yuitsu-leather/ULP_leather_keycap/img/IMG_7734.jpg

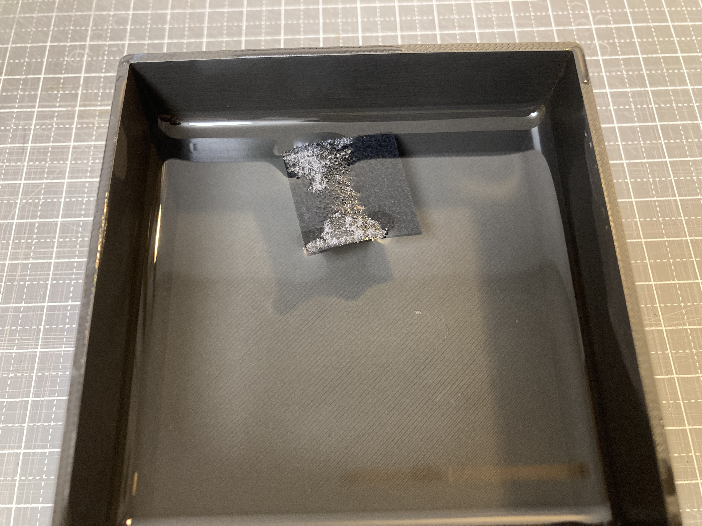
img/IMG_7734.jpg
