yuitsu-leather/ULP_leather_keycap/model/common/leather_ruler_guide_22mm.stl

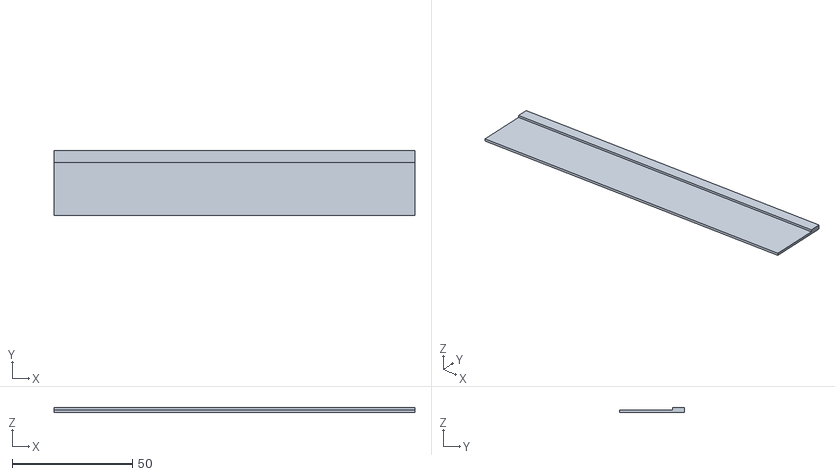
[picture p21: CAD file, 2026-11-08]
model/common/leather_ruler_guide_22mm.stl
150.0 x 27.0 x 1.90
