yuitsu-leather/ULP_leather_keycap/model/cylindrical/cylindrical_press.stl

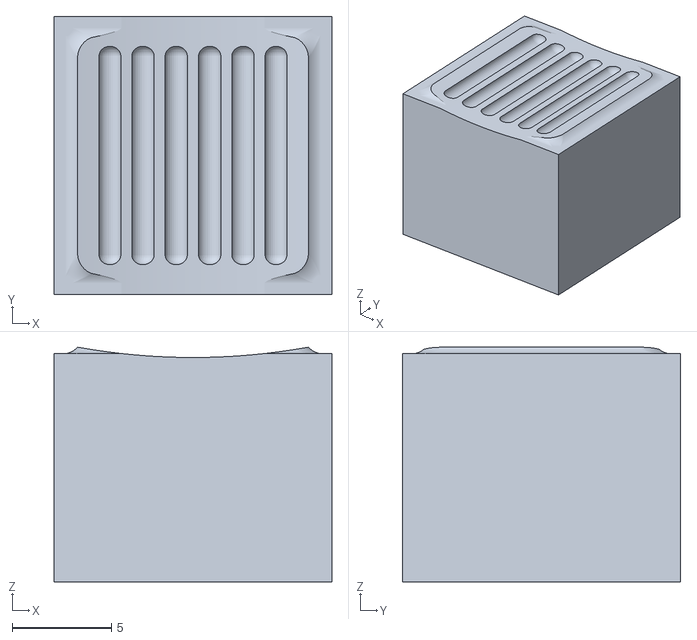
[picture p22: CAD file, 2026-11-06]
model/cylindrical/cylindrical_press.stl
14.0 x 14.0 x 11.8
