yuitsu-leather/ULP_leather_keycap/model/common/hook.stl

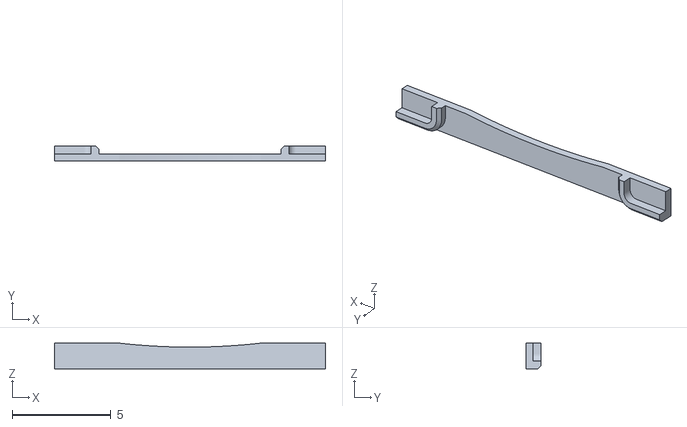
[picture p23: CAD file, 2026-11-06]
model/common/hook.stl
13.7 x 0.75 x 1.30
