yuitsu-leather/ULP_leather_keycap/model/cylindrical/cylindrical_cutting_guide.stl

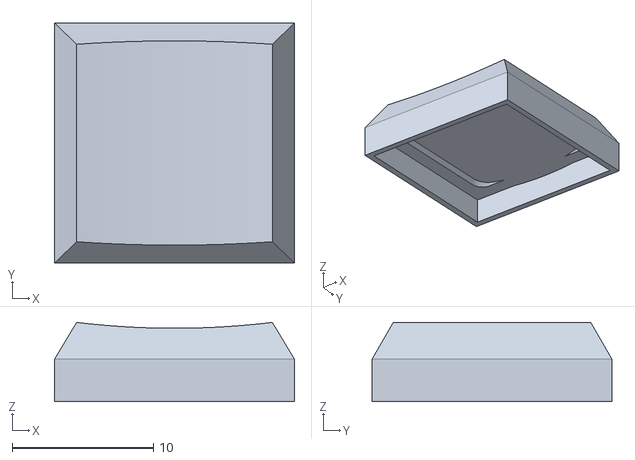
[picture p24: CAD file, 2026-11-06]
model/cylindrical/cylindrical_cutting_guide.stl
17.0 x 17.0 x 5.61
