yuitsu-leather/ULP_leather_keycap/model/common/spatula.stl

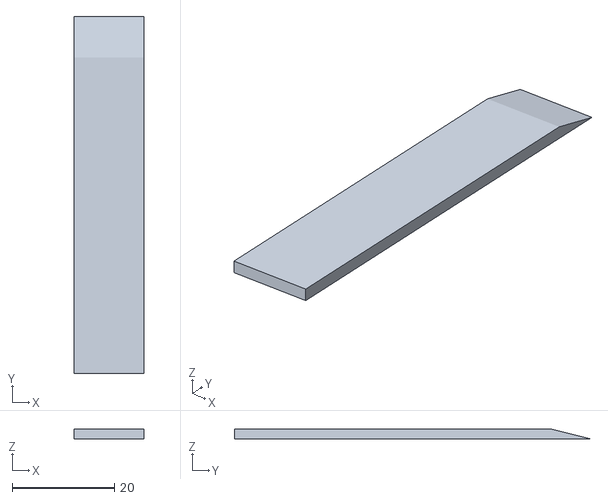
[picture p25: CAD file, 2026-11-06]
model/common/spatula.stl
13.7 x 70.0 x 2.00
