yuitsu-leather/ULP_leather_keycap/model/cylindrical/cylindrical_mold.stl

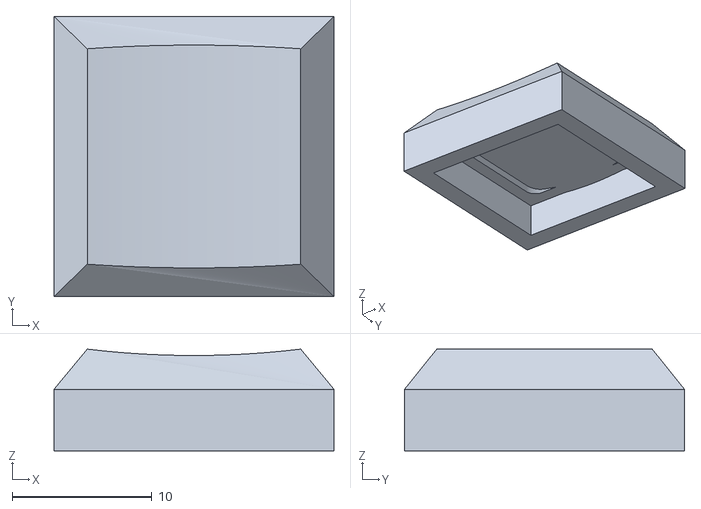
[picture p26: CAD file, 2026-11-06]
model/cylindrical/cylindrical_mold.stl
20.0 x 20.0 x 7.27
