yuitsu-leather/ULP_leather_keycap/model/common/hook_alignment_guide.stl

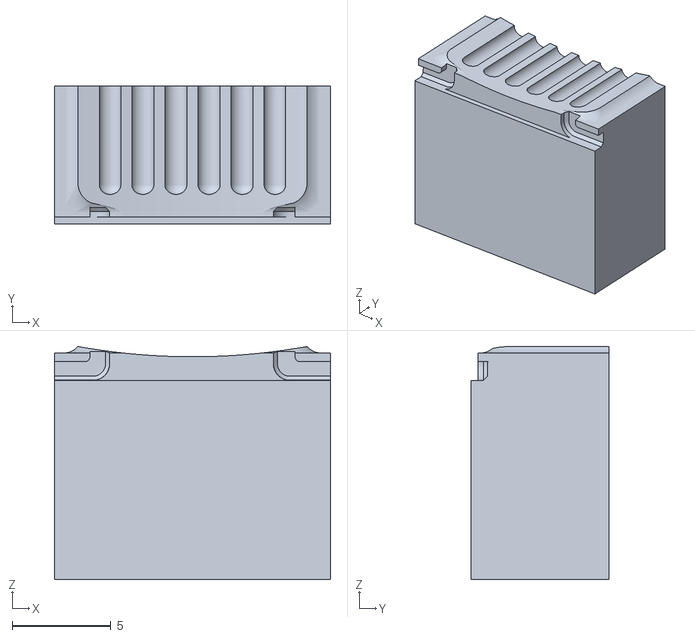
[picture p27: CAD file, 2026-11-06]
model/common/hook_alignment_guide.stl
14.0 x 7.00 x 11.8
