yuitsu-leather/ULP_leather_keycap/(list of files, cad)

Other CAD files:
model/homing/homing_press.stl
model/homing/homing_cutting_guide.stl
model/homing/homing_mold.stl
