yuitsu-leather/ULP_leather_keycap/(commit log)

2026-11-06 モデルの追加
    [cylindrical_cutting_guide.stl, cylindrical_mold.stl, cylindrical_press.stl, homing_cutting_guide.stl, homing_mold.stl, homing_press.stl, hook.stl, hook_alignment_guide.stl]
2026-11-08 README.md、LICENSE.mdの追加
    [leather_ruler_guide_22mm.stl]
